nicc777/arduino_elec_and_temp_monitor/images/20181215_101636462_iOS.jpg

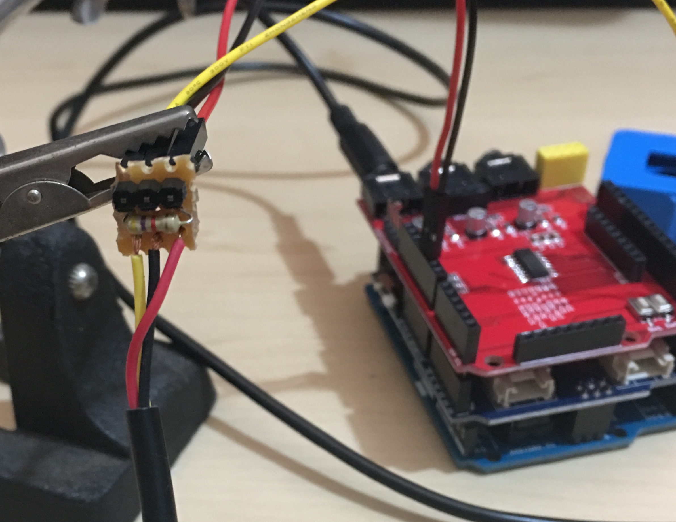
images/20181215_101636462_iOS.jpg
